arihant93/OPENSDL/4P4C connector wiring.png

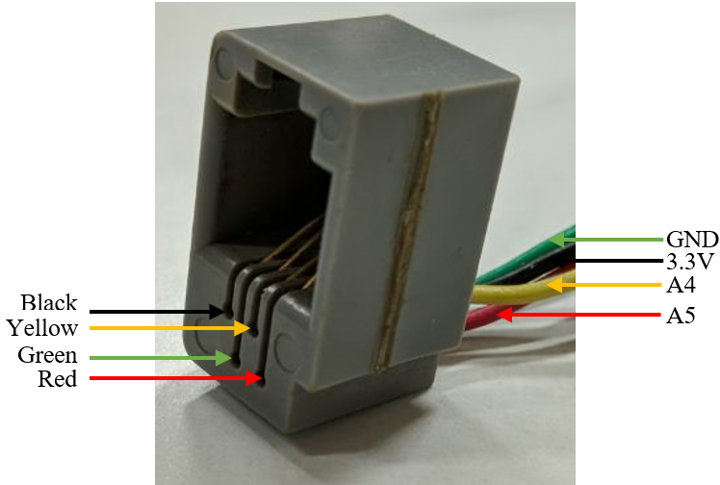
4P4C connector wiring.png
