arihant93/OPENSDL/Solder connections on customised shield.png

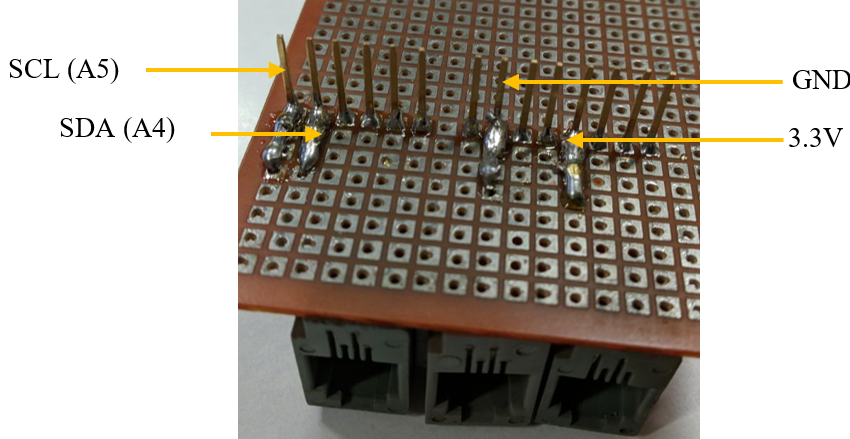
Solder connections on customised shield.png
