arihant93/OPENSDL/Arduino Uno and Data Logger shield.png

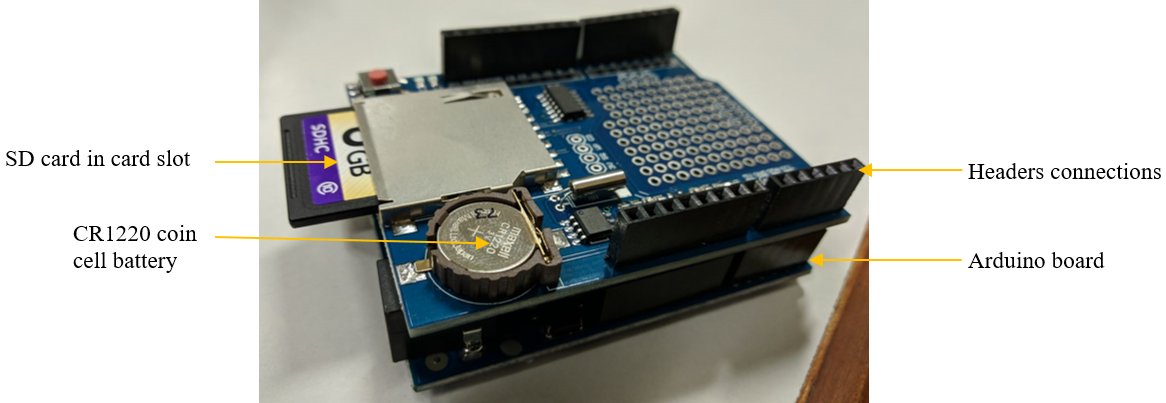
Arduino Uno and Data Logger shield.png
