arihant93/OPENSDL/BME280 connected to 4P4C connector.png

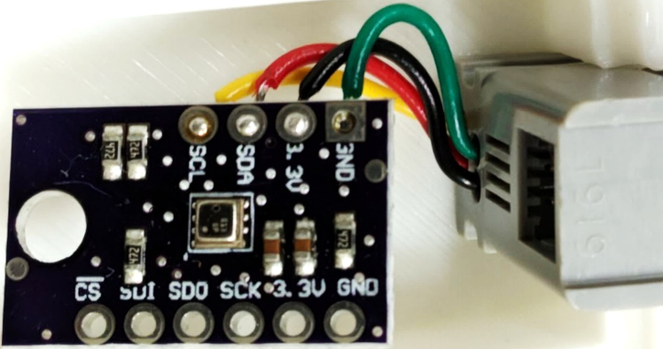
BME280 connected to 4P4C connector.png
