arihant93/OPENSDL/Custom connector shield.png

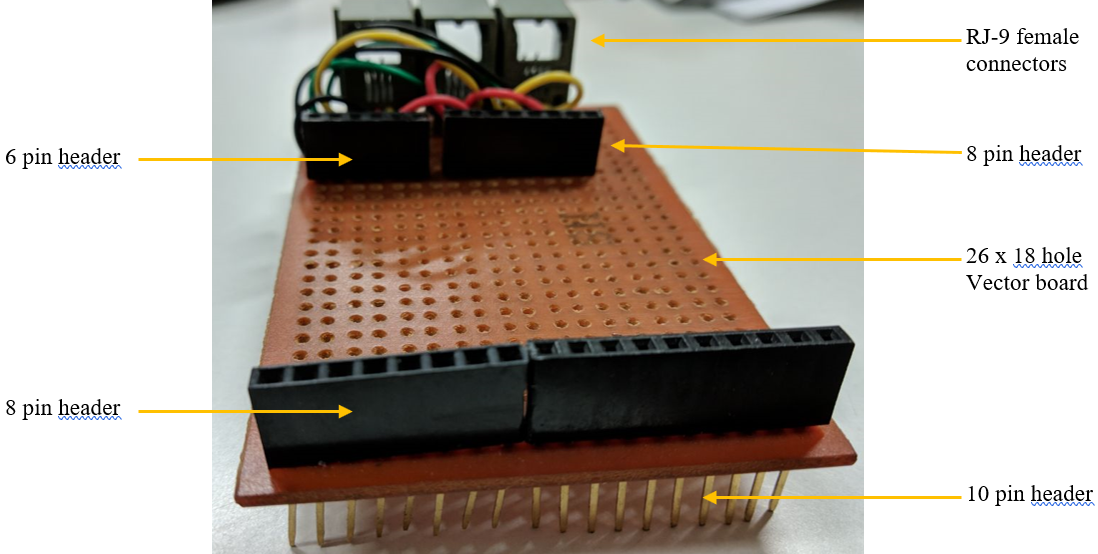
Custom connector shield.png
